trentdye/gamekid/README.md

# gamekid
Source files for my portable gaming device.
