trentdye/gamekid/cad/SingleButton.STL

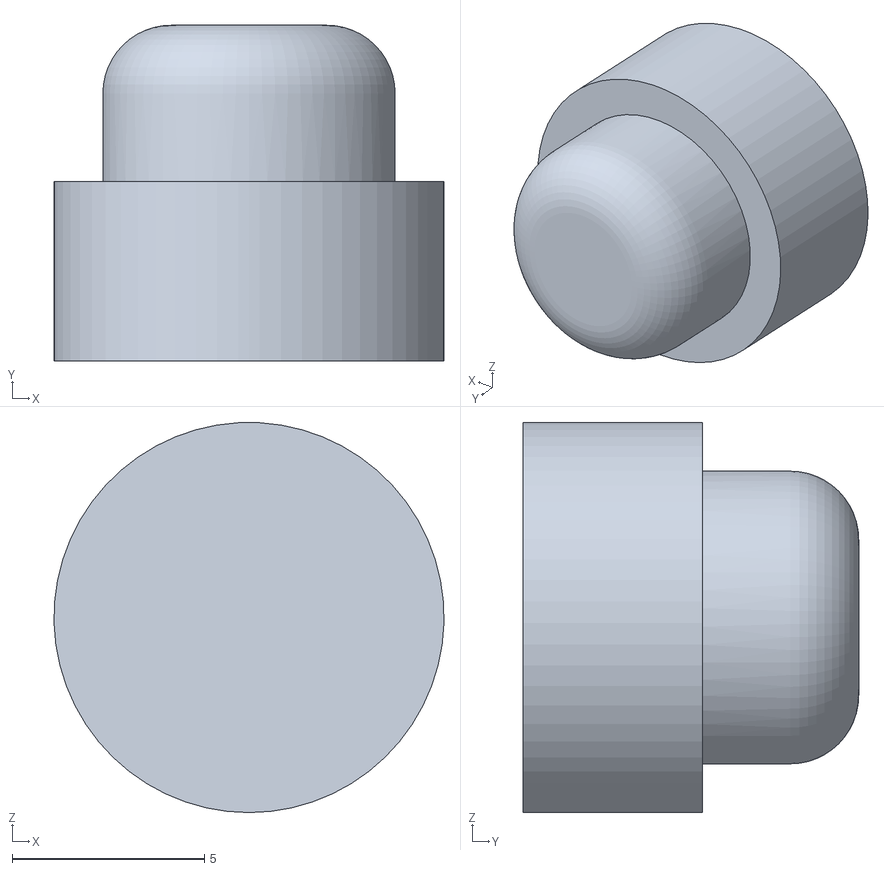
[picture p9: CAD file, 2018-05-16]
cad/SingleButton.STL
10.2 x 8.74 x 10.2
