trentdye/gamekid/cad/Case Bottom.STL

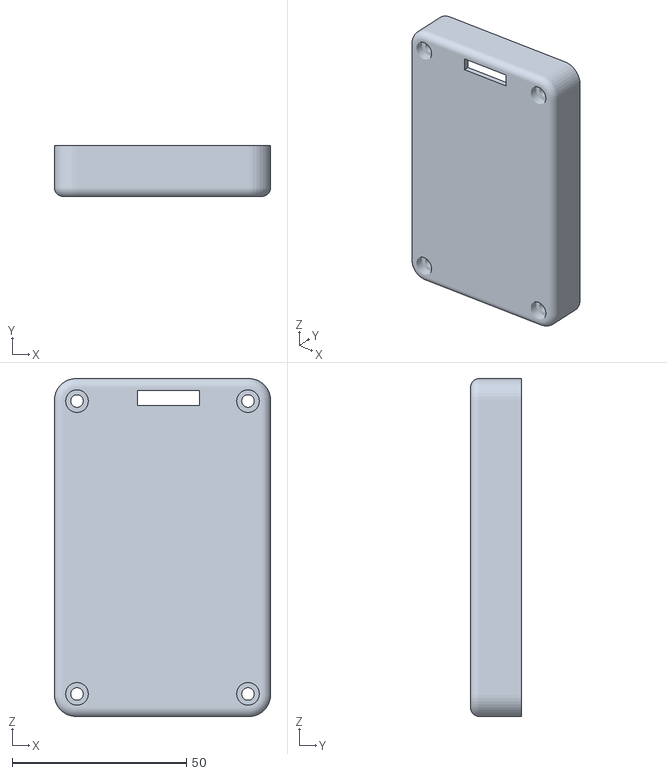
[picture p10: CAD file, 2018-05-16]
cad/Case Bottom.STL
62.0 x 14.6 x 96.9
