trentdye/gamekid/cad/Case Top.STL

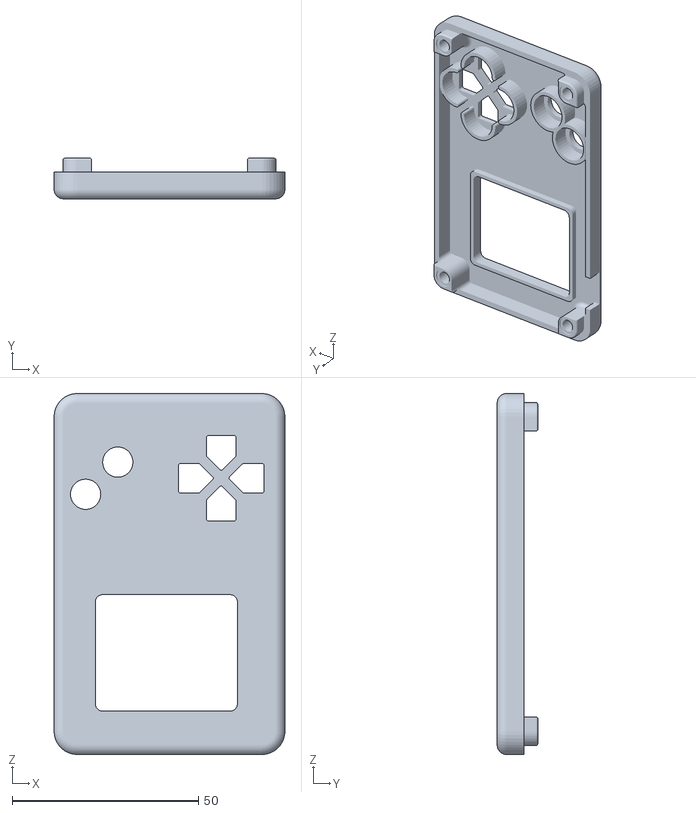
[picture p11: CAD file, 2018-05-16]
cad/Case Top.STL
62.0 x 10.9 x 96.9
