trentdye/gamekid/cad/DirSingleButton.STL

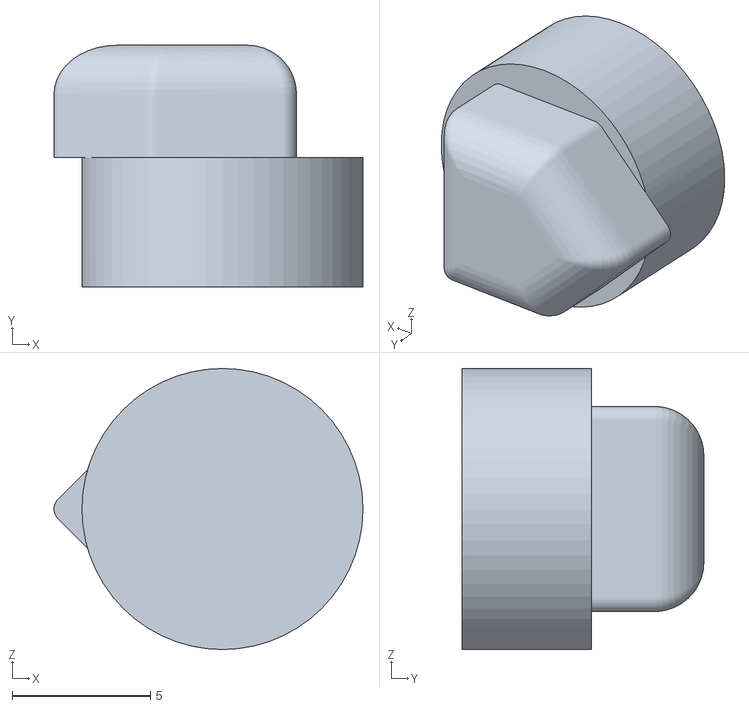
[picture p12: CAD file, 2018-05-16]
cad/DirSingleButton.STL
11.2 x 8.74 x 10.2
