trentdye/gamekid/cad/Screen Locator.STL

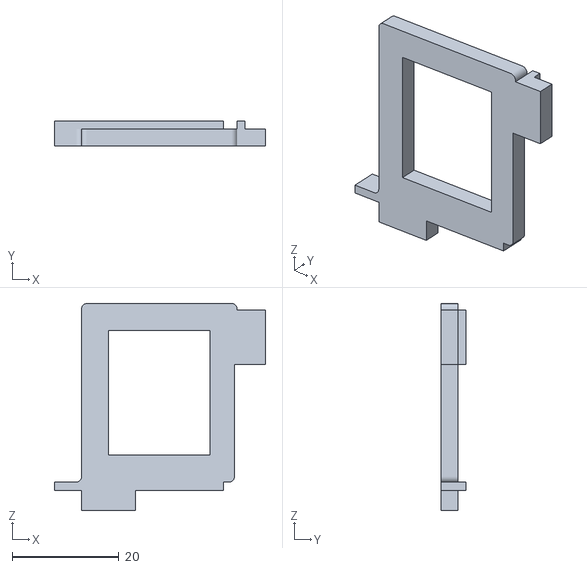
[picture p13: CAD file, 2018-05-16]
cad/Screen Locator.STL
39.6 x 4.75 x 38.9
