trentdye/gamekid/electronics/kicad/first_project.kicad_pcb

## KiCad design electronics/kicad/first_project.kicad_pcb (2018-05-16)

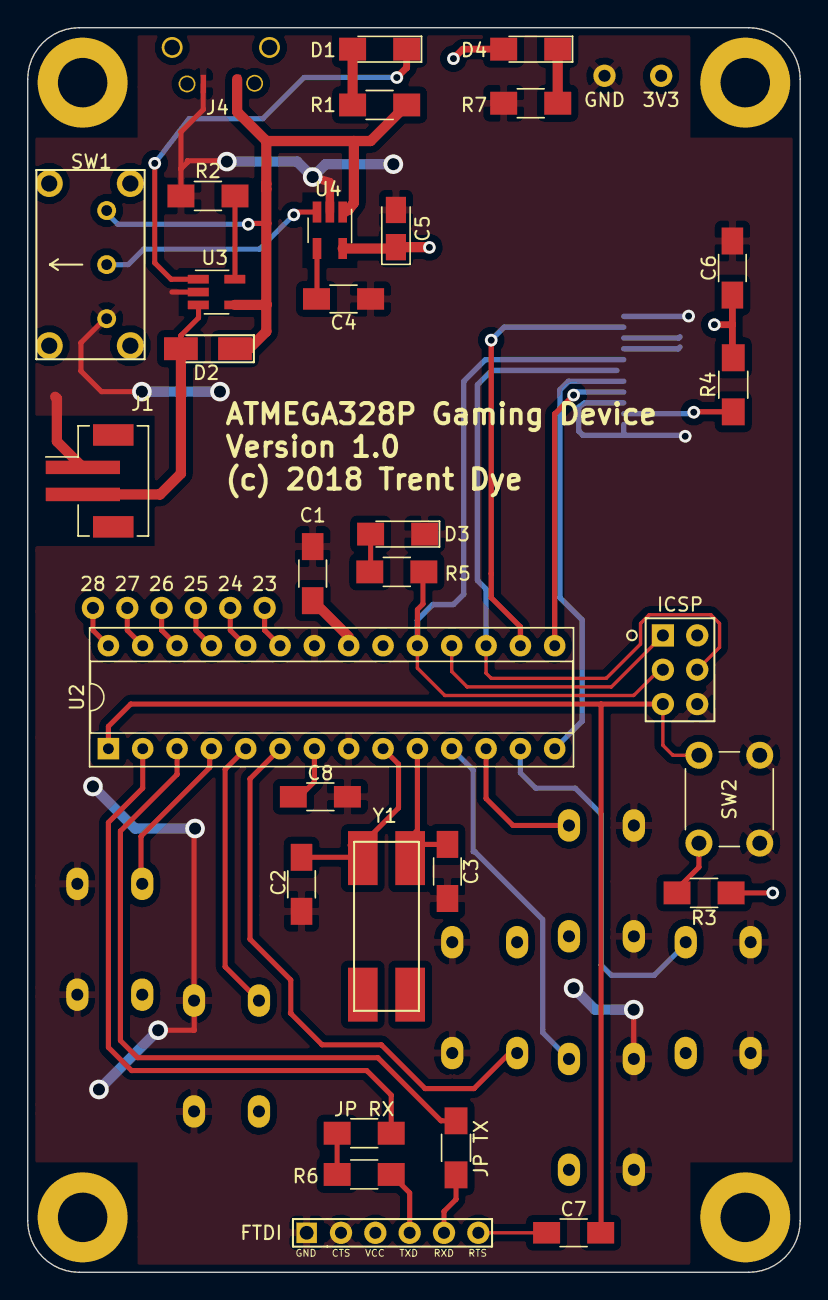
[picture p14: board first_project.kicad_pcb from above]

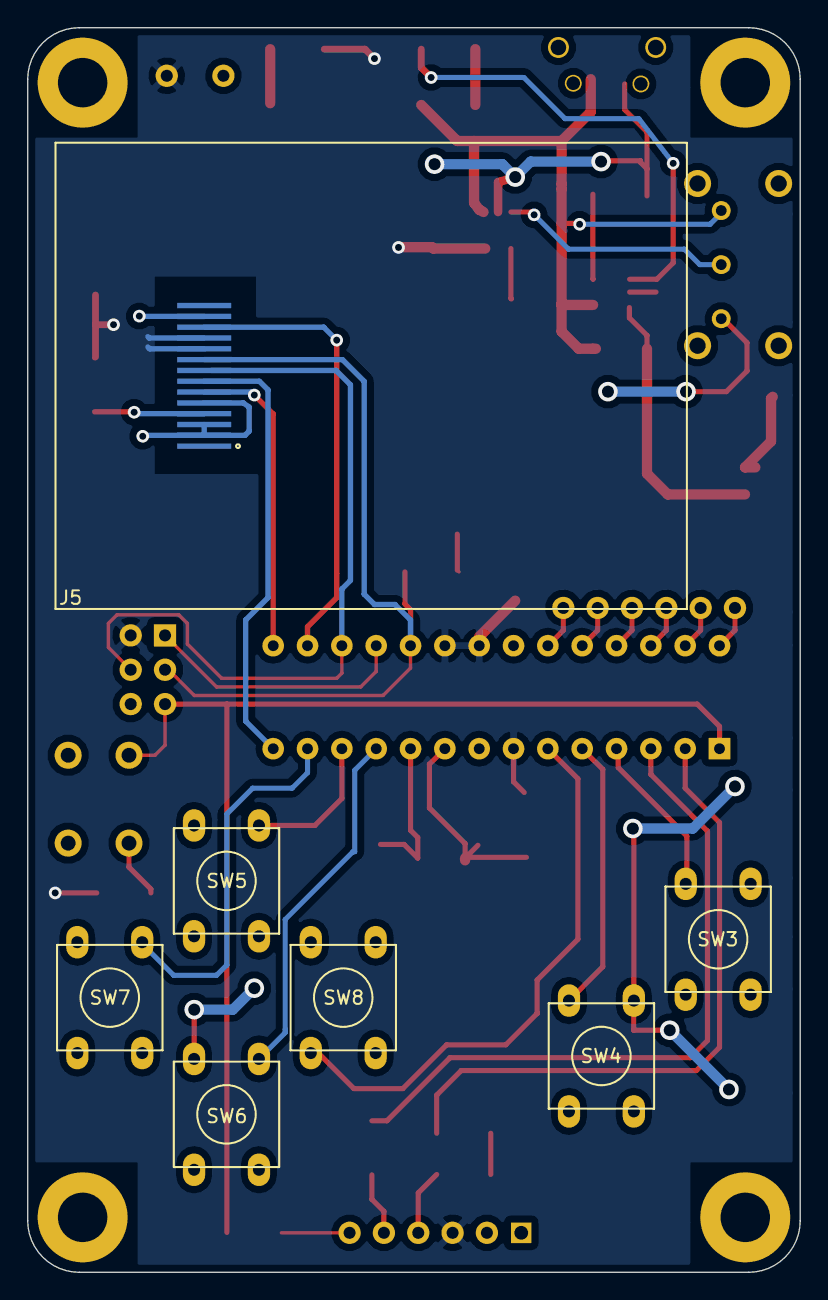
[picture p15: board first_project.kicad_pcb from below]

Board: 2 copper layers, 57.1 x 92.1 mm, 46 parts (7 on the bottom side), 39 nets.

Parts:
3V3: +3.3V; TP
23: PC0; TP
24: PC1; TP
25: PC2; TP
26: PC3; TP
27: PC4; TP
28: PC5; TP
C1, C7, C8: 0.1 uF; C_1206_HandSoldering
C2, C3: 20pF; C_1206_HandSoldering
C4: 470pf; C_1206_HandSoldering
C5: 10uF; CP_Tantalum_Case-S_EIA-3216-12_Reflow
C6: .1uF; C_1206_HandSoldering
D1, D3, D4: LED; LED_1206_HandSoldering
D2: B340A
FTDI: FTDI_HEADER
GND: TEST; TP
ICSP: ICSP_HEADER
J1: JST; JST_PH_B2B-PH-SM4-TB_02x2.00mm_Straight
J4: MICROUSB; 10118194-0001LF
J5: 1.8IN_TFT_ST7735_RIBBON; JDT-1800
JP RX: MCU_RXD; R_1206_HandSoldering
JP TX: MCU_TXD; R_1206_HandSoldering
R1: 330; R_1206_HandSoldering
R2: 10k; R_1206_HandSoldering
R3, R6: 10K; R_1206_HandSoldering
R4: 22; R_1206_HandSoldering
R5, R7: 60; R_1206_HandSoldering
SW1: 1825232-1; EG1224
SW2: 450-1647-ND; SW_PUSH_6mm_h4.3mm
SW3: BTN_A; ADAFRUIT_SOFT_TOUCH_BUTTON
SW4: BTN_B; ADAFRUIT_SOFT_TOUCH_BUTTON
SW5: BTN_U; ADAFRUIT_SOFT_TOUCH_BUTTON
SW6: BTN_D; ADAFRUIT_SOFT_TOUCH_BUTTON
SW7: BTN_L; ADAFRUIT_SOFT_TOUCH_BUTTON
SW8: BTN_R; ADAFRUIT_SOFT_TOUCH_BUTTON
U2: ATMEGA328P-PU; DIP-28_W7.62mm_Socket
U3: MCP73831; SOT-23-5_HandSoldering
U4: MIC5219-3.3; SOT-23-5_HandSoldering
Y1: CrystalSMD4Pin; ECS-80-16-28AX-TR

Connections:
+3V3: 3V3.1, C1.1, C5.1, C6.1, C8.1, D4.2, FTDI.3, ICSP.2, J5.10, J5.11, R3.1, R4.2, U2.7, U2.20, U2.21, U4.5
+BATT: D2.2, J1.2, U3.3
BUTTON_A: SW3.1, U2.4
BUTTON_B: SW4.1, U2.5
BUTTON_DOWN: SW6.1, U2.11
BUTTON_LEFT: SW7.1, U2.13
BUTTON_RIGHT: SW8.1, U2.6
BUTTON_UP: SW5.1, U2.12
CS: J5.12, U2.16
DISP_LED+: J5.4, R4.1
DISP_RESET: J5.6, U2.15
DISP_RS: J5.7, U2.14
GND: C1.2, C2.2, C3.2, C4.1, C5.2, C6.2, C8.2, D3.1, FTDI.1, FTDI.2, GND.1, ICSP.6, J1.1, J4.5, J5.2, J5.3, J5.5, J5.13, R2.1, R7.2, SW1.3, SW2.2, SW3.2, SW4.2, SW5.2, SW6.2, SW7.2, SW8.2, U2.8, U2.22, U3.2, U4.2
MCU_RESET: C7.2, ICSP.5, R3.2, SW2.1, U2.1
MISO: ICSP.1, U2.18
MOSI: ICSP.4, J5.8, U2.17
unnamed: C4.2, U4.4
unnamed: C7.1, FTDI.6
unnamed: D1.1, U3.1
unnamed: D1.2, R1.1
unnamed: D3.2, R5.1
unnamed: D4.1, R7.1
unnamed: FTDI.4, R6.1
unnamed: FTDI.5, JP TX.2
unnamed: JP RX.2, R6.2
unnamed: R2.2, U3.5
unnamed: SW1.2, U4.3
unnamed: 23.1, U2.23
unnamed: 24.1, U2.24
unnamed: 25.1, U2.25
unnamed: 26.1, U2.26
unnamed: 27.1, U2.27
unnamed: 28.1, U2.28
RXD: JP RX.1, U2.2
SCK: ICSP.3, J5.9, R5.2, U2.19
TXD: JP TX.1, U2.3
VBUS: D2.1, J4.1, R1.2, SW1.1, U3.4, U4.1
XTAL1: C2.1, U2.9, Y1.1
XTAL2: C3.1, U2.10, Y1.4
