trentdye/gamekid/(commit log)

2018-05-16 Added source code and (e)CAD files.
    [Case Bottom.STL, Case Top.STL, DirSingleButton.STL, Screen Locator.STL, SingleButton.STL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]
2018-05-16 Added BOM
