trentdye/gamekid/(notices)

Notices in the files:
electronics/kicad/first_project.kicad_pcb:
(c) 2018 Trent Dye
